Will-Dub/2V4U/Hardware/VCU_Board.kicad_pcb

## KiCad design Hardware/VCU_Board.kicad_pcb (2026-11-11)

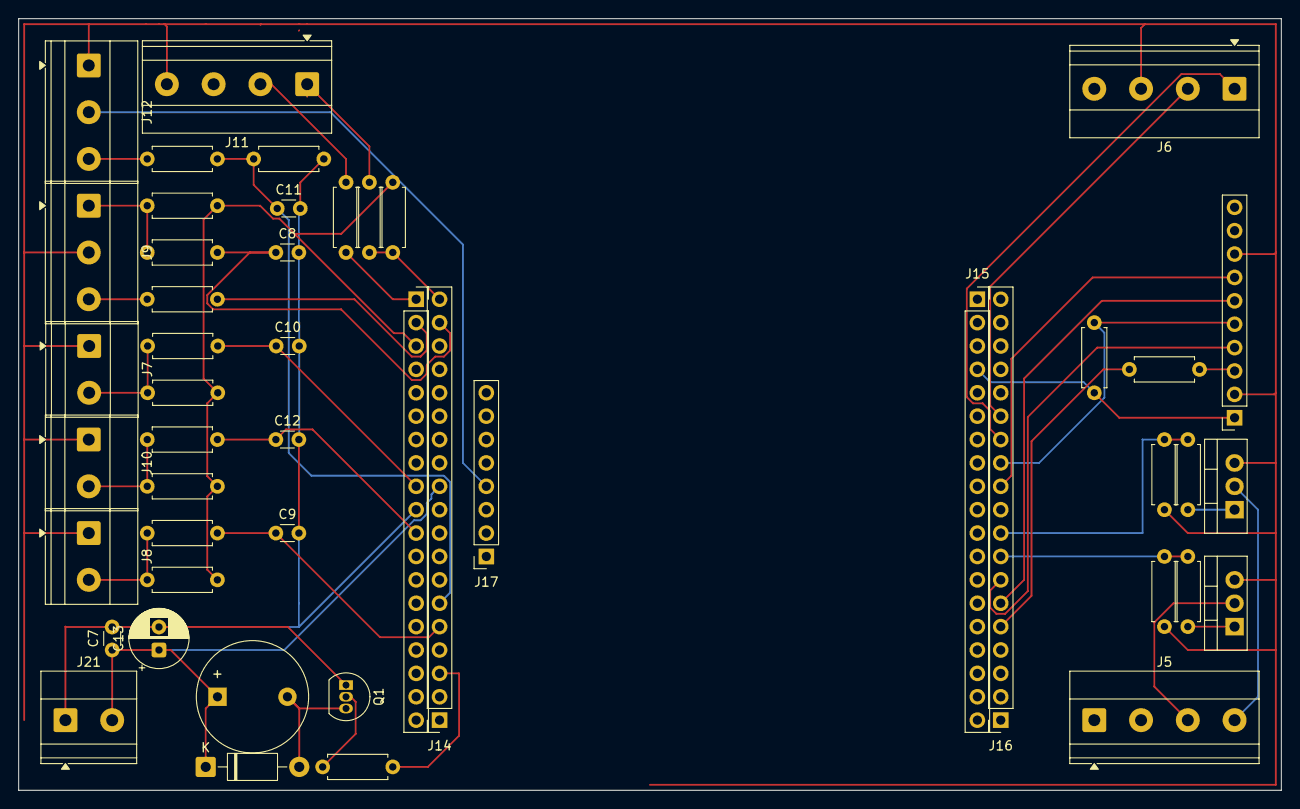
[picture p1: board VCU_Board.kicad_pcb from above]

Board: 2 copper layers, 137.2 x 83.8 mm, 48 parts (0 on the bottom side), 36 nets.

Parts:
BZ1: Buzzer; Buzzer_12x9.5RM7.6
C7: 0.1μ; C_Disc_D3.0mm_W1.6mm_P2.50mm
C8, C9, C10, C11, C12: 100n; C_Disc_D3.0mm_W1.6mm_P2.50mm
C13: 10μ; CP_Radial_D6.3mm_P2.50mm
D4: D; D_DO-41_SOD81_P10.16mm_Horizontal
J3: ICM-20948; PinSocket_1x10_P2.54mm_Vertical
J5: Power Connector; TerminalBlock_Phoenix_MKDS-1,5-4-5.08_1x04_P5.08mm_Horizont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
J6: CAN Connector; TerminalBlock_Phoenix_MKDS-1,5-4-5.08_1x04_P5.08mm_Horizont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
J7: Direction Connector; TerminalBlock_Phoenix_MKDS-1,5-2-5.08_1x02_P5.08mm_Horizont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
J8: Brake Connector; TerminalBlock_Phoenix_MKDS-1,5-2-5.08_1x02_P5.08mm_Horizont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
J9: Sw Start Connector; TerminalBlock_Phoenix_MKDS-1,5-3-5.08_1x03_P5.08mm_Horizont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
J10: Emergency NO Connector; TerminalBlock_Phoenix_MKDS-1,5-2-5.08_1x02_P5.08mm_Horizont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
J11: BMS Connector; TerminalBlock_Phoenix_MKDS-1,5-4-5.08_1x04_P5.08mm_Horizont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
J12: Throttle Connector; TerminalBlock_Phoenix_MKDS-1,5-3-5.08_1x03_P5.08mm_Horizont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
J13, J14, J15, J16: Conn_01x19; PinSocket_1x19_P2.54mm_Vertical
J17: Conn_01x08; PinSocket_1x08_P2.54mm_Vertical
J21: Supply Connector; TerminalBlock_Phoenix_MKDS-1,5-2-5.08_1x02_P5.08mm_Horizont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
Q1: PN2222A; TO-92_Inline
Q3, Q4: MOSFET_CONTACTOR; TO-220-3_Vertical
R2, R20: 10000; R_Axial_DIN0207_L6.3mm_D2.5mm_P7.62mm_Horizontal
R3: 20000; R_Axial_DIN0207_L6.3mm_D2.5mm_P7.62mm_Horizontal
R4, R5, R6, R7, R19: 1000; R_Axial_DIN0207_L6.3mm_D2.5mm_P7.62mm_Horizontal
R8, R11, R13: 10k; R_Axial_DIN0207_L6.3mm_D2.5mm_P7.62mm_Horizontal
R9: 33; R_Axial_DIN0207_L6.3mm_D2.5mm_P7.62mm_Horizontal
R10: 270; R_Axial_DIN0207_L6.3mm_D2.5mm_P7.62mm_Horizontal
R12, R14: 100; R_Axial_DIN0207_L6.3mm_D2.5mm_P7.62mm_Horizontal
R15, R16, R17, R18: 2200; R_Axial_DIN0207_L6.3mm_D2.5mm_P7.62mm_Horizontal
R21, R22: 220; R_Axial_DIN0207_L6.3mm_D2.5mm_P7.62mm_Horizontal

Connections:
+3.3V: J3.1 (VCC), J13.3, J14.12, J15.4, J17.5, R4.1, R5.1, R6.1, R7.1, R8.1, R20.2
+5V: BZ1.1 (+), C7.1, C13.1, D4.1 (K), J12.2, J14.11, J17.4, J21.2
/Driver/MOSFET_CONTACTOR_DRAIN: J5.3, Q4.2 (D)
/Driver/MOSFET_CONTACTOR_GATE: J16.8, R13.2, R14.1
/Driver/MOSFET_PRECHARGE_DRAIN: J5.4, Q3.2 (D)
/Driver/MOSFET_PRECHARGE_GATE: J16.9, R11.2, R12.1
/Interfaces/BMS_RX: J14.19, R20.1, R21.2
/Interfaces/BMS_TX: J13.1, R22.2
/Interfaces/BUZZER: J14.3, R19.2
/Interfaces/IMU_INT: J3.7 (INT), J16.11
/Interfaces/LED_SW_START: J13.2, R10.2
/Interfaces/SPI2_IMU_NCS: J3.5 (NCS), J16.12, R8.2
/Interfaces/SPI2_MISO: J3.6 (SDO), J16.6
/Interfaces/SPI2_MOSI: J3.4 (SDI), J16.7
/Interfaces/SPI2_SCK: J16.5, R9.1
/Interfaces/SW_BRAKE: C9.1, J14.5, R16.2
/Interfaces/SW_DIRECTION: C10.1, J13.9, R17.2
/Interfaces/SW_PUSH_EMERGENCY: C12.1, J13.11, R18.2
/Interfaces/SW_START: C8.1, J14.18, R15.1
/Interfaces/THROTTLE_ADC: C11.1, J14.6, R2.1, R3.1
/Off board high voltage/CAN_RX: J6.1, J16.13
/Off board high voltage/CAN_TX: J6.2, J16.14
GND: C7.2, C8.2, C9.2, C10.2, C11.2, C12.2, C13.2, J3.2 (GND), J3.8 (FSY), J6.3, J7.1, J8.1, J9.2, J10.1, J11.4, J12.1, J13.10, J14.9, J14.10, J14.16, J15.5, J16.4, J16.10, J17.2, J17.3, J21.1, Q1.1 (E), Q3.3 (S), Q4.3 (S), R3.2, R11.1, R13.1
unnamed: BZ1.2 (-), D4.2 (A), Q1.3 (C)
unnamed: J3.3 (SCLK), R9.2
unnamed: J7.2, R7.2, R17.1
unnamed: J8.2, R6.2, R16.1
unnamed: J9.1, R4.2, R15.2
unnamed: J9.3, R10.1
unnamed: J10.2, R5.2, R18.1
unnamed: J11.1, R21.1
unnamed: J11.2, R22.1
unnamed: J12.3, R2.2
unnamed: Q1.2 (B), R19.1
unnamed: Q3.1 (G), R12.2
unnamed: Q4.1 (G), R14.2
