Will-Dub/2V4U/Software/VCU/Core/Src/main.c

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
/* Includes ------------------------------------------------------------------*/
#include "main.h"
#include "adc.h"
#include "dma.h"
#include "fdcan.h"
#include "iwdg.h"
#include "usart.h"
#include "spi.h"
#include "tim.h"
#include "gpio.h"

/* USER CODE BEGIN Includes */
#include "App.h"
#include <stdio.h>
/* USER CODE END Includes */

/* USER CODE BEGIN PM */
#define ADC_BUFFER_SIZE 100
/* USER CODE END PM */


/* USER CODE BEGIN PV */
extern UART_HandleTypeDef hlpuart1;
volatile uint16_t adcBuffer[ADC_BUFFER_SIZE];
/* USER CODE END PV */

void SystemClock_Config(void);
/* USER CODE BEGIN 0 */
// Printf redirected to this
int _write(int file, char *ptr, int len) {
    HAL_UART_Transmit(&hlpuart1, (uint8_t *)ptr, len, HAL_MAX_DELAY);
    return len;
}
/* USER CODE END 0 */

/**
  * @brief  The application entry point.
  * @retval int
  */
int main(void)
{

  /* MCU Configuration--------------------------------------------------------*/

  /* Reset of all peripherals, Initializes the Flash interface and the Systick. */
  HAL_Init();

  /* Configure the system clock */
  SystemClock_Config();

  /* Initialize all configured peripherals */
  MX_GPIO_Init();
  MX_DMA_Init();
  MX_FDCAN1_Init();
  MX_ADC1_Init();
  MX_LPUART1_UART_Init();
  MX_SPI2_Init();
  MX_TIM6_Init();
  MX_IWDG_Init();
  MX_UART4_Init();
  /* USER CODE BEGIN 2 */
  HAL_TIM_Base_Start_IT(&htim6);
  HAL_ADCEx_Calibration_Start(&hadc1, ADC_SINGLE_ENDED);
  HAL_ADC_Start_DMA(&hadc1, (uint32_t*)adcBuffer, ADC_BUFFER_SIZE);

  App_Init(adcBuffer);
  setvbuf(stdout, NULL, _IONBF, 0);
  /* USER CODE END 2 */

  /* Infinite loop */
  /* USER CODE BEGIN WHILE */
  while (1)
  {
    App_Run();
    /* USER CODE END WHILE */

    /* USER CODE BEGIN 3 */
  }
  /* USER CODE END 3 */
}

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
