Will-Dub/2V4U/Software/VCU/App/Inc/Logic/VcuController.hpp

#pragma once
#include "ILogger.hpp"
#include "VcuStateDrive.hpp"
#include "VcuStateFault.hpp"
#include "VcuStateInit.hpp"
#include "VcuStatePrecharge.hpp"
#include "VcuStateShutdown.hpp"
#include "VcuStateStandby.hpp"

#define THROTTLE_RELEASE_THRESHOLD 0.05f

namespace App::Logic {
class VcuController
{
  private:
    ILogger& m_logger;
    VcuStateStandby m_stateStandby;
    VcuStatePrecharge m_statePrecharge;
    VcuStateDrive m_stateDrive;
    VcuStateFault m_stateFault;
    VcuStateShutdown m_stateShutdown;
    VcuStateInit m_stateInit;
    VcuState* m_currentState;
    bool m_isInReverse = false;
    bool m_isBrakeThrottleLatched = true;

    VcuState* getStateInstance(VcuStateId id);
    void transitionToState(VcuStateId nextStateId, const VcuInputs& inputs);

  public:
    VcuController(ILogger& logger);
    void run(const VcuInputs& inputs, VcuOutputs& outputs);
    void init(const VcuInputs& inputs);
    VcuStateId getCurrentVcuStateId() const;
    bool getIsInReverse() const
    {
        return m_isInReverse;
    }
    bool getIsBrakeThrottleLatched() const
    {
        return m_isBrakeThrottleLatched;
    }
};
} // namespace App::Logic
