Will-Dub/2V4U/Software/VCU/App/Inc/Logic/VcuStateInit.hpp

#pragma once
#include "VcuState.hpp"

namespace App::Logic {

class VcuStateInit : public VcuState
{
  public:
    VcuStateInit(ILogger& logger) : VcuState(logger) {}
    void onEnter(const VcuInputs& inputs) override;
    virtual VcuStateId update(const VcuInputs& inputs, VcuOutputs& outputs) override;
    virtual VcuStateId getId() override;
};

} // namespace App::Logic
