Will-Dub/2V4U/Software/VCU/App/Inc/Logic/VcuStatePark.hpp

#pragma once
#include "VcuState.hpp"

namespace App::Logic {

class VcuStatePark : public VcuState
{
  public:
    void onEnter() override;
    virtual VcuStateId update(const VcuInputs& inputs, VcuOutputs& outputs) override;
};

} // namespace App::Logic
