Will-Dub/2V4U/Software/VCU/App/Src/App.cpp

#include "App.h"

#include "BmsDriver.hpp"
#include "Buzzer.hpp"
#include "DashTransmitter.hpp"
#include "DebounceButton.hpp"
#include "ImuDriver.hpp"
#include "StmLogger.hpp"
#include "ThrottleHallSensor.hpp"
#include "VcuController.hpp"
#include "VcuStateInit.hpp"
#include "VcuStruct.hpp"
#include "VescCanDriver.hpp"
#include "main.h"

#include <math.h>
#include <stdio.h>

extern SPI_HandleTypeDef hspi2;
extern IWDG_HandleTypeDef hiwdg;
extern UART_HandleTypeDef huart4;

static App::Infrastructure::DashTransmitter dashTransmitter;
static App::Infrastructure::StmLogger stmLogger;
static App::Logic::VcuController vcuController(stmLogger);
static App::Drivers::Buzzer buzzer(BUZZER_GPIO_Port, BUZZER_Pin);
static App::Drivers::ThrottleHallSensor throttleSensor;
static App::Drivers::BmsDriver bmsDriver(huart4);
static App::Drivers::VescCanDriver vescDriver(hfdcan1);
static App::Drivers::DebounceButton brakeButton;
static App::Drivers::DebounceButton boardButton;
static App::Drivers::DebounceButton eStopButton;
static App::Drivers::DebounceButton forwardButton;
static App::Drivers::DebounceButton startButton;
static App::Drivers::ImuDriver imuDriver(hspi2, SPI2_IMU_NCS_GPIO_Port, SPI2_IMU_NCS_Pin);
volatile bool tick = false;
volatile bool imuDataReady = false;

extern "C" void HAL_GPIO_EXTI_Callback(uint16_t GPIO_Pin)
{
    if (GPIO_Pin == IMU_INT_Pin) {
        imuDataReady = true;
    }
}

extern "C" void HAL_TIM_PeriodElapsedCallback(TIM_HandleTypeDef* htim)
{
    if (htim->Instance == TIM6) {
        tick = true;
    }
}

extern "C" void HAL_UARTEx_RxEventCallback(UART_HandleTypeDef* huart, uint16_t size)
{
    if (huart == &huart4)
        bmsDriver.onRxEvent(size);
}

extern "C" void HAL_UART_ErrorCallback(UART_HandleTypeDef* huart)
{
    if (huart == &huart4)
        bmsDriver.onUartError();
}

extern "C" void HAL_FDCAN_RxFifo0Callback(FDCAN_HandleTypeDef* hfdcan, uint32_t RxFifo0ITs)
{
    if (hfdcan->Instance == FDCAN1) {
        vescDriver.onRxFifo0();
    }
}

static void gatherInputs(App::Logic::VcuInputs& inputs, uint32_t currentTickMs)
{
    inputs.tickMs = currentTickMs;

    // Buttons/Switch
    bool rawBrake = (HAL_GPIO_ReadPin(SW_BRAKE_GPIO_Port, SW_BRAKE_Pin) == GPIO_PIN_RESET);
    bool rawBoard = (HAL_GPIO_ReadPin(BTN_BOARD_GPIO_Port, BTN_BOARD_Pin) == GPIO_PIN_SET);
    bool rawEStop = (HAL_GPIO_ReadPin(SW_PUSH_EMERGENCY_GPIO_Port, SW_PUSH_EMERGENCY_Pin) ==
                     GPIO_PIN_RESET);
    bool rawForward = (HAL_GPIO_ReadPin(SW_DIRECTION_GPIO_Port, SW_DIRECTION_Pin) ==
                       GPIO_PIN_RESET);
    bool rawStart = (HAL_GPIO_ReadPin(SW_START_GPIO_Port, SW_START_Pin) == GPIO_PIN_RESET);

    brakeButton.update(currentTickMs, rawBrake);
    boardButton.update(currentTickMs, rawBoard);
    eStopButton.update(currentTickMs, rawEStop);
    forwardButton.update(currentTickMs, rawForward);
    startButton.update(currentTickMs, rawStart);

    inputs.pilot.isBrakePressed = brakeButton.isPressed();
    inputs.pilot.isBtnBoardPressed = boardButton.isPressed();
    inputs.pilot.isEStopPressed = eStopButton.isPressed();
    inputs.pilot.isForwardDirection = forwardButton.isPressed();
    inputs.pilot.isStartPressed = startButton.isPressed();
    inputs.pilot.isStartRisingEdge = startButton.isRisingEdge();

    // Throttle
    throttleSensor.update();
    inputs.pilot.throttlePercent = throttleSensor.getPercent();
    inputs.pilot.isThrottleValid = throttleSensor.getIsValid();

    // IMU
    static float imuAx = 0.0f, imuAy = 0.0f, imuAz = 1.0f;
    static float imuGx = 0.0f, imuGy = 0.0f, imuGz = 0.0f;
    static float imuTemp = 0.0f;
    static bool imuIsDataValid = false;

    if (imuDataReady) {
        imuDataReady = false;

        imuIsDataValid = imuDriver.readSensorData(imuAx, imuAy, imuAz, imuGx, imuGy, imuGz,
                                                  imuTemp);
    }

    inputs.imu.isValid = imuIsDataValid;

    if (imuIsDataValid) {
        inputs.imu.Ax = imuAx;
        inputs.imu.Ay = imuAy;
        inputs.imu.Az = imuAz;
        inputs.imu.Gx = imuGx;
        inputs.imu.Gy = imuGy;
        inputs.imu.Gz = imuGz;
        inputs.imu.temp = imuTemp;
    }

    inputs.vesc = vescDriver.getData();
}

static void applyOutputs(App::Logic::VcuOutputs& outputs, uint32_t currentTickMs)
{
    HAL_GPIO_WritePin(LED_BOARD_GPIO_Port, LED_BOARD_Pin,
                      outputs.lights.boardLed ? GPIO_PIN_SET : GPIO_PIN_RESET);
    HAL_GPIO_WritePin(MOSFET_CONTACTOR_GATE_GPIO_Port, MOSFET_CONTACTOR_GATE_Pin,
                      outputs.power.contactor ? GPIO_PIN_SET : GPIO_PIN_RESET);
    HAL_GPIO_WritePin(MOSFET_PRECHARGE_GATE_GPIO_Port, MOSFET_PRECHARGE_GATE_Pin,
                      outputs.power.prechargeRelay ? GPIO_PIN_SET : GPIO_PIN_RESET);
    HAL_GPIO_WritePin(LED_SW_START_GPIO_Port, LED_SW_START_Pin,
                      outputs.lights.startLed ? GPIO_PIN_SET : GPIO_PIN_RESET);

    if (outputs.vesc.isMotorEnabled) {
        vescDriver.sendAmpCommand(outputs.vesc.targetAmp);
    } else {
        vescDriver.sendAmpCommand(0.0f);
    }

    buzzer.set(outputs.buzzer.mode, outputs.buzzer.beepMs, outputs.buzzer.pauseMs);
}

extern "C" void App_Init(volatile uint16_t* throttleDmaPtr)
{
    vescDriver.init();
    bmsDriver.init();
    throttleSensor.init(throttleDmaPtr);
    imuDriver.init();

    App::Logic::VcuInputs inputs;
    inputs.tickMs = HAL_GetTick();
    vcuController.init(inputs);

    stmLogger.infof("Init finished");
}

extern "C" void App_Run(void)
{
    uint32_t currentTickMs = HAL_GetTick();

    vescDriver.processSlots();
    bmsDriver.process(currentTickMs);

    if (!tick)
        return;

    tick = false;

    App::Logic::VcuOutputs outputs{};
    App::Logic::VcuInputs inputs{};

    gatherInputs(inputs, currentTickMs);

    vcuController.run(inputs, outputs);

    applyOutputs(outputs, currentTickMs);

    dashTransmitter.process(vcuController.getCurrentVcuStateId(), inputs, outputs);
    buzzer.update(currentTickMs);

    HAL_IWDG_Refresh(&hiwdg);
}
