Will-Dub/2V4U/Software/VCU/App/Inc/Logic/VcuStruct.hpp

#pragma once
#include <stdint.h>

namespace App::Logic {

enum class BuzzerMode : uint8_t
{
    OFF = 0,
    ON,
    BEEP_ONCE,
    BEEP_LOOP
};

enum class VcuStateId
{
    INIT,
    STANDBY,
    PRECHARGE,
    DRIVE,
    FAULT,
    SHUTDOWN,
    SAME,
};

struct VescData
{
    int32_t rpm;
    float motorCurrent = 0;
    float inputCurrent = 0;
    float inputVoltage = 0;
    float mosfetTemp = 0;
    float motorTemp = 0;
    uint32_t lastRxMs = 0;
    uint32_t followedTxFailCount = 0;
    uint32_t txFailCount = 0;
    uint32_t rxCount = 0;
    uint32_t txCount = 0;
};

struct VcuInputs
{
    struct
    {
        bool isBrakePressed = false;
        bool isBtnBoardPressed = false;
        bool isEStopPressed = true;
        bool isForwardDirection = false;
        bool isStartPressed = false;
        bool isStartRisingEdge = false;
        float throttlePercent = 0.0f;
        bool isThrottleValid = false;
    } pilot;

    struct
    {
        float Ax = 0.0f, Ay = 0.0f, Az = 1.0f;
        float Gx = 0.0f, Gy = 0.0f, Gz = 0.0f;
        float temp = 0.0f;
        bool isValid = false;
    } imu;

    VescData vesc;

    uint32_t tickMs = 0;
};

struct VcuOutputs
{
    struct
    {
        bool prechargeRelay = false;
        bool contactor = false;
    } power;

    struct
    {
        bool isMotorEnabled = false;
        float targetAmp = 0.0f;
    } vesc;

    struct
    {
        bool boardLed = false;
        bool errorLed = false;
        bool startLed = false;
    } lights;

    struct
    {
        BuzzerMode mode = BuzzerMode::OFF;
        uint32_t beepMs = 0;
        uint32_t pauseMs = 0;
    } buzzer;
};



}; // namespace App::Logic
