Will-Dub/2V4U/(commit log)

2026-09-28 Pin assignment
2026-09-29 Printf over lpuart
2026-09-30 Added BOM
    [kart-bom.csv]
2026-09-30 Added kicad schema
    [VCU_Board.kicad_pcb, VCU_Board.kicad_sch]
2026-09-30 Start adding ICM 20948
    [VCU_Board.kicad_sch]
2026-10-01 Add DMA + throttle driver
2026-10-05 Start adding debounce button
2026-10-06 Added debounce for all buttons
2026-10-07 Added dbc + can bus translation matrix
2026-10-07 Start refactor VCU schema
    [AnalogIO.kicad_sch, CAN_Network.kicad_sch, DigitalIO.kicad_sch, Driver.kicad_sch, Power_Supply.kicad_sch, STM32_MCU.kicad_sch, SystemWiring.kicad_sch, VCU_Board.kicad_sch]
2026-10-07 Restructure VCU schema
    [CAN_Network.kicad_sch, Driver.kicad_sch, Interfaces.kicad_sch, Offboard_HV.kicad_sch, Power_Supply.kicad_sch, Power_Switch.kicad_sch, SystemWiring.kicad_sch, VCU_Board.kicad_sch]
2026-10-09 CAN Vesc + add state logic
2026-10-09 Add low pass filter + fix adc sampling
    [Interfaces.kicad_sch]
2026-10-17 Added IMU driver
2026-10-18 Split i/o + add imu to inputs
2026-10-18 Add transmission stm32 side
2026-10-25 Added Debug page+ more telemetry + VESC fix
2026-10-30 Set footprint + excludes
2026-11-01 Add RC filter + start pcb
2026-11-01 Add initial protoboard layout + pin change
2026-11-02 Add buzzer to pcb
2026-11-02 Add buzzer driver
2026-11-03 Fix terminal footprint
2026-11-03 Fix EStop pin + pcb
2026-11-04 Start adding BMS UART to pcb
2026-11-04 Add UART Resistor + pull up pcb
2026-11-05 Start adding BMS driver + fix pcb
2026-11-11 Move pin for easier routing
2026-11-11 Small Vesc can driver refactor
2026-11-12 Add throttleMapper + move to svg
